CamK06/CATS-Base-Hardware/CATSTNC-R2.kicad_pcb

## KiCad design CATSTNC-R2.kicad_pcb (2024-10-06)

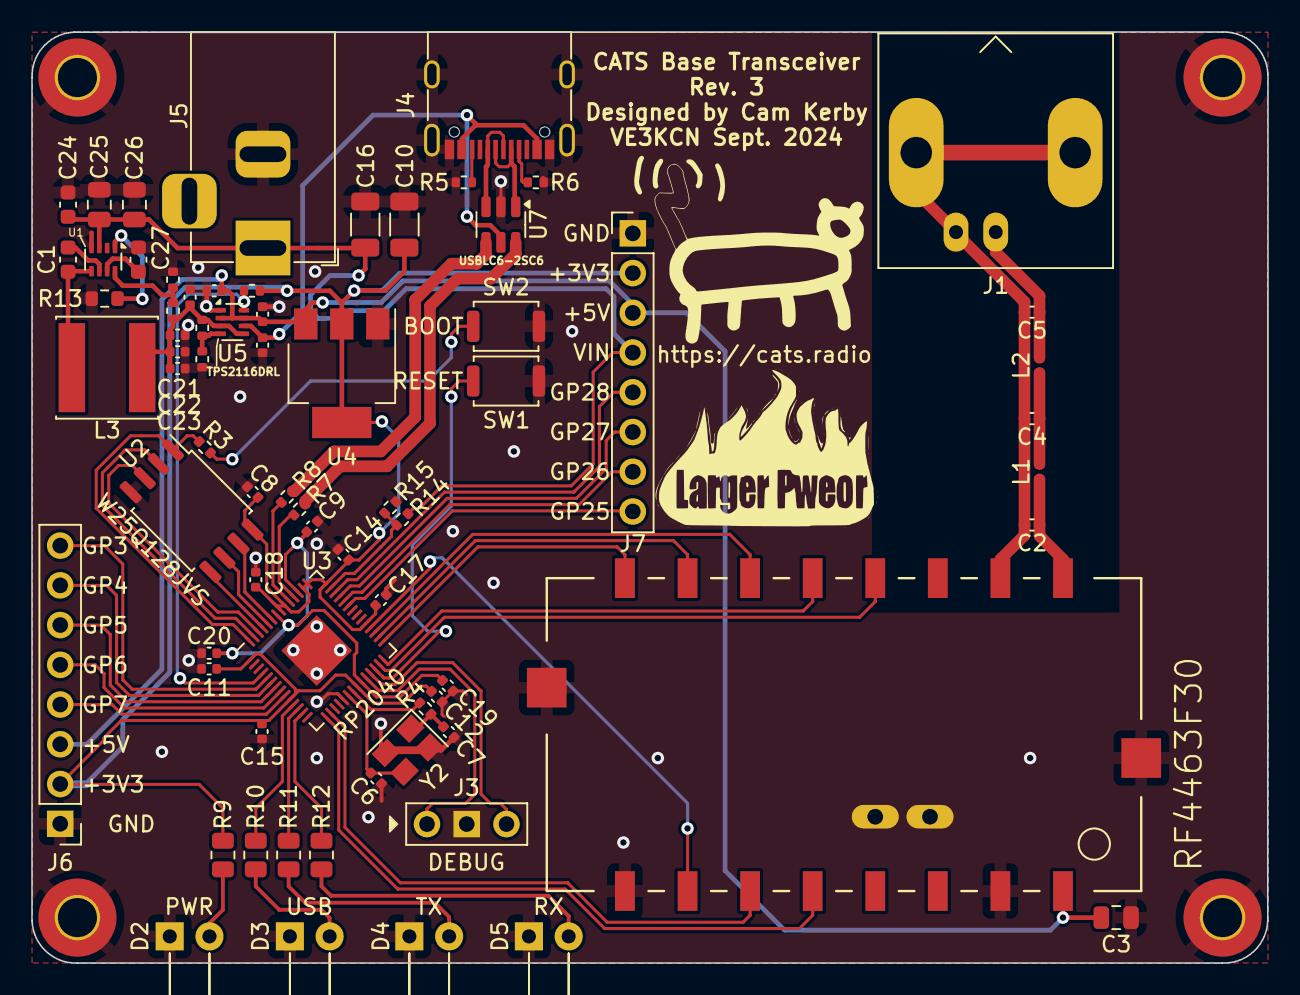
[picture p1: board CATSTNC-R2.kicad_pcb from above]

Board: 2 copper layers, 79.0 x 59.5 mm, 75 parts (0 on the bottom side), 64 nets.

Parts:
C1, C24: 100nF; C_0603_1608Metric
C2, C5: 7.5pF; C_0402_1005Metric
C3: 4.7uF; C_0805_2012Metric
C4: 13pF; C_0402_1005Metric
C6, C7: 27pF; C_0402_1005Metric
C8, C12, C14, C15, C17, C19, C20, C23: 100nF; C_0402_1005Metric
C9, C11, C18: 1uF; C_0402_1005Metric
C10, C16: 4.7uF; C_1206_3216Metric
C13, C28, C29, C30: 10uF; C_0402_1005Metric
C21, C22: 22uF; C_0402_1005Metric
C25, C26: 10uF; C_0805_2012Metric
C27: 33nF; C_0603_1608Metric
D2, D3, D4, D5: LED; LED_D3.0mm_Horizontal_O6.35mm_Z6.0mm
H1, H2, H3, H4: MountingHole_2.5mm_Pad_TopBottom
J1: BNC; BNC_Amphenol_B6252HB-NPP3G-50_Horizontal
J3: DEBUG; PinHeader_1x03_P2.54mm_Vertical
J4: USB_C_Receptacle_USB2.0; USB_C_Receptacle_G-Switch_GT-USB-7010ASV
J5: DC IN; BarrelJack_Horizontal
J6: GPIO-1; PinHeader_1x08_P2.54mm_Vertical
J7: GPIO-2; PinHeader_1x08_P2.54mm_Vertical
L1, L2: 24nH; L_0402_1005Metric
L3: 6.8uH; L_Sunlord_SWPA6020S
R1, R14, R17: 54.9K 1%; R_0402_1005Metric
R2, R15: 10.0K 1%; R_0402_1005Metric
R3: 1K; R_0402_1005Metric
R4: 1k; R_0402_1005Metric
R5, R6: 5.11K; R_0402_1005Metric
R7, R8: 27 or 22; R_0402_1005Metric
R9, R10, R11, R12: 220; R_0805_2012Metric
R13: 0; R_0603_1608Metric
R18: 15.0K 1%; R_0402_1005Metric
R19: 10K; R_0402_1005Metric
SW1: RESET; SW_Push_SPST_NO_Alps_SKRK
SW2: BOOT; SW_Push_SPST_NO_Alps_SKRK
U1: TPS62933; SOT-583-8
U2: W25Q128JVS; SOIC-8_5.23x5.23mm_P1.27mm
U3: RP2040; QFN-56-1EP_7x7mm_P0.4mm_EP3.2x3.2mm
U4: NCP1117-3.3_SOT223; SOT-223-3_TabPin2
U5: TPS2116DRL; SOT-583-8
U6: RF4463F30
U7: USBLC6-2SC6; SOT-23-6
Y2: C9002; Crystal_SMD_3225-4Pin_3.2x2.5mm

Connections:
+1V1: C9.1, C19.1, C20.1, U3.23 (DVDD), U3.45 (VREG_VOUT), U3.50 (DVDD)
+3V3: C8.1, C10.1, C11.1, C12.1, C14.1, C15.1, C17.1, C18.1, J6.2, J7.2, R9.2, R19.2, U2.8 (VCC), U3.1 (IOVDD), U3.10 (IOVDD), U3.22 (IOVDD), U3.33 (IOVDD), U3.42 (IOVDD), U3.43 (ADC_AVDD), U3.44 (VREG_IN), U3.48 (USB_VDD), U3.49 (IOVDD), U4.2 (VO)
+5V: C3.1, C29.1, C30.1, J6.3, J7.3, U4.3 (VI), U5.2 (VOUT), U5.7 (VOUT), U6.1 (VCC)
D+: R8.2, U7.4 (I/O2)
D-: R7.2, U7.6 (I/O1)
GND: C3.2, C6.2, C7.2, C8.2, C9.2, C10.2, C11.2, C12.2, C13.2, C14.2, C15.2, C16.2, C17.2, C18.2, C19.2, C20.2, C21.2, C22.2, C23.2, C24.2, C25.2, C26.2, C27.2, C28.2, C29.2, C30.2, D2.1 (K), D3.1 (K), D4.1 (K), D5.1 (K), H1.1, H2.1, H3.1, H4.1, J3.2, J4.A1 (GND), J4.A12 (GND), J4.B1 (GND), J4.B12 (GND), J4.S1 (SHIELD), J5.2, J6.1, J7.1, R2.2, R5.2, R6.1, R13.2, R15.2, R18.1, SW1.1, SW2.1, U1.4 (GND), U2.4 (GND), U3.19 (TESTEN), U3.57 (GND), U4.1 (GND), U5.1 (GND), U6.2 (GND), U6.8 (GND), U6.SHLD_1, U6.SHLD_2, U6.SHLD_3, U6.SHLD_4, U7.2 (GND), Y2.2, Y2.4
GNDA: C2.2, C4.2, C5.2, J1.2 (Ext), U6.15 (GND)
GP3: J6.8, U3.5 (GPIO3)
GP4: J6.7, U3.6 (GPIO4)
GP5: J6.6, U3.7 (GPIO5)
GP6: J6.5, U3.8 (GPIO6)
GP7: J6.4, U3.9 (GPIO7)
GP25: J7.8, U3.37 (GPIO25)
GP26: J7.7, U3.38 (GPIO26_ADC0)
GP27: J7.6, U3.39 (GPIO27_ADC1)
GP28: J7.5, U3.40 (GPIO28_ADC2)
IRQ: U3.16 (GPIO13), U6.6 (IRQ)
MUX_ST: R19.1, U3.4 (GPIO2), U5.8 (ST)
unnamed: C4.1, L1.2, L2.1
unnamed: C7.1, R4.2, Y2.1
unnamed: D2.2 (A), R9.1
unnamed: D3.2 (A), R10.1
unnamed: D4.2 (A), R11.1
unnamed: D5.2 (A), R12.1
unnamed: C5.1, J1.1 (In), L2.2
unnamed: J4.A5 (CC1), R6.2
unnamed: J4.B5 (CC2), R5.1
unnamed: J4.A6 (D+), J4.B6 (D+), U7.3 (I/O2)
unnamed: J4.A7 (D-), J4.B7 (D-), U7.1 (I/O1)
unnamed: R3.1, SW2.2
unnamed: C1.1, U1.6 (BST)
unnamed: C27.1, U1.7 (SS)
unnamed: C1.2, L3.1, U1.5 (SW)
unnamed: SW1.2, U3.26 (RUN)
unnamed: R7.1, U3.46 (USB_DM)
unnamed: R8.1, U3.47 (USB_DP)
unnamed: C6.1, U3.20 (XIN), Y2.3
unnamed: R4.1, U3.21 (XOUT)
unnamed: R17.1, R18.2, U5.4 (PR1)
unnamed: C2.1, L1.1, U6.16 (ANT)
QSPI_CLK: U2.6 (CLK), U3.52 (QSPI_SCLK)
QSPI_SD0: U2.5 (DI(IO0)), U3.53 (QSPI_SD0)
QSPI_SD1: U2.2 (DO(IO1)), U3.55 (QSPI_SD1)
QSPI_SD2: U2.3 (IO2), U3.54 (QSPI_SD2)
QSPI_SD3: U2.7 (IO3), U3.51 (QSPI_SD3)
QSPI_SS: R3.2, U2.1 (~CS), U3.56 (QSPI_SS)
REG_5V: C13.1, C21.1, C22.1, C23.1, L3.2, R1.1, R17.2, U5.3 (VIN1), U5.5 (MODE)
RFGP0: U3.27 (GPIO16), U6.13 (GPIO0)
RFGP1: U3.28 (GPIO17), U6.12 (GPIO1)
RT: R13.1, U1.1 (RT)
RX_LED: R12.2, U3.13 (GPIO10)
SDN: U3.15 (GPIO12), U6.5 (SDN)
SPI0_CSN: U3.32 (GPIO21), U6.7 (SEL)
SPI0_RX: U3.31 (GPIO20), U6.11 (SDO)
SPI0_SCK: U3.29 (GPIO18), U6.9 (SCLK)
SPI0_TX: U3.30 (GPIO19), U6.10 (SDI)
SWCLK: J3.1, U3.24 (SWCLK)
SWD: J3.3, U3.25 (SWD)
TX_LED: R11.2, U3.12 (GPIO9)
USB_LED: R10.2, U3.11 (GPIO8)
USB_VBUS: C28.1, J4.A4 (VBUS), J4.A9 (VBUS), J4.B4 (VBUS), J4.B9 (VBUS), U5.6 (VIN2), U7.5 (VBUS)
VCC: C16.1, C24.1, C25.1, C26.1, J5.1, J7.4, R14.1, U1.3 (VIN)
VCC_VOLTS: R14.2, R15.1, U3.41 (GPIO29_ADC3)
VFB: R1.2, R2.1, U1.8 (FB)
