CamK06/CATS-Base-Hardware/(commit log)

2023-11-29 Improve design
    [CATSTNC-R2.kicad_pcb, CATSTNC-R2.kicad_sch]
2023-12-02 More work
    [CATSTNC-R2.kicad_sch]
2023-12-05 Rev 2 Ordered
    [CATSTNC-R2.kicad_pcb, CATSTNC-R2.kicad_sch]
2024-09-26 Start work on Rev 3
    [CATSTNC-R2.kicad_pcb, CATSTNC-R2.kicad_sch]
2024-09-27 More work on Rev 3
    [CATSTNC-R2.kicad_pcb]
2024-09-27 Rev 3
    [CATSTNC-R2.kicad_pcb]
2024-09-27 Remove BAT54C
    [CATSTNC-R2.kicad_pcb, CATSTNC-R2.kicad_sch]
2024-09-27 Add power mux, USB TVS
    [CATSTNC-R2.kicad_pcb, CATSTNC-R2.kicad_sch]
2024-09-27 JLC part selection
    [CATSTNC-R2.kicad_pcb]
2024-09-28 Add SWD header, VCC voltmeter, replace GP29 with VIN
    [CATSTNC-R2.kicad_pcb, CATSTNC-R2.kicad_sch]
2024-10-06 Did some stuff idk
    [CATSTNC-R2.kicad_pcb, CATSTNC-R2.kicad_sch]
2024-10-06 BOOT silkscreen text alignment was bothering me
    [CATSTNC-R2.kicad_pcb]
2024-10-06 Made some small optimizations: see full commit message.
    * Changed PCB text font to Liberation Sans
    * Re-added semiconductor part values to front silkscreen
    * Moved GPIO header closer to edge of board, per general practice
    * Moved some existing silkscreen messages
    [CATSTNC-R2.kicad_pcb]
